GewoonMaarten/soil-sensor/README.md

# soil-sensor 🌱
Schematic and PCB for a capacitive soil moisture sensor.

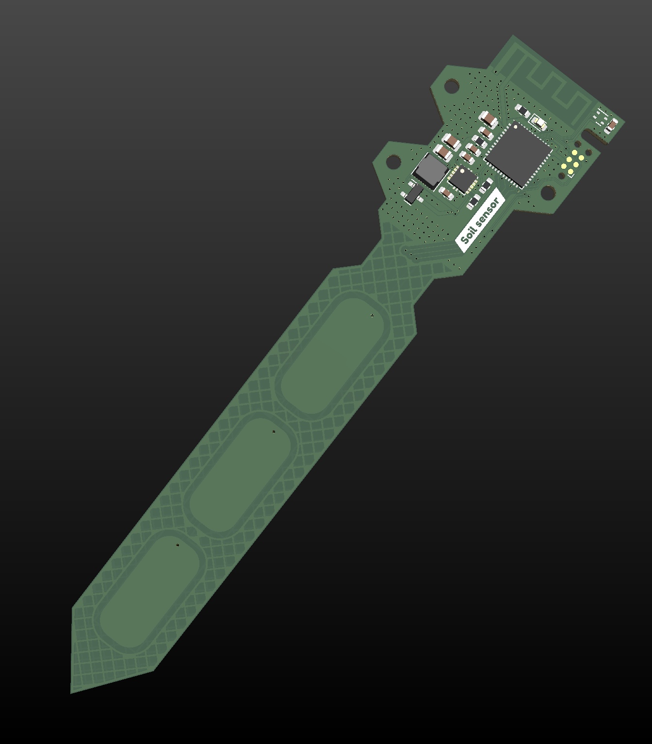
[picture p1: docs/soil_sensor_2.png]
latest release


**See [latest release](../../releases/latest) for schematic and gerbers.**
