GewoonMaarten/soil-sensor/devices/soil-sensor/hardware/v2/README.md

# Out-of-phase soil sensor

Based on the [Capacitive-Based Liquid Level Sensing Sensor Reference Design](https://www.ti.com/tool/TIDA-00317).

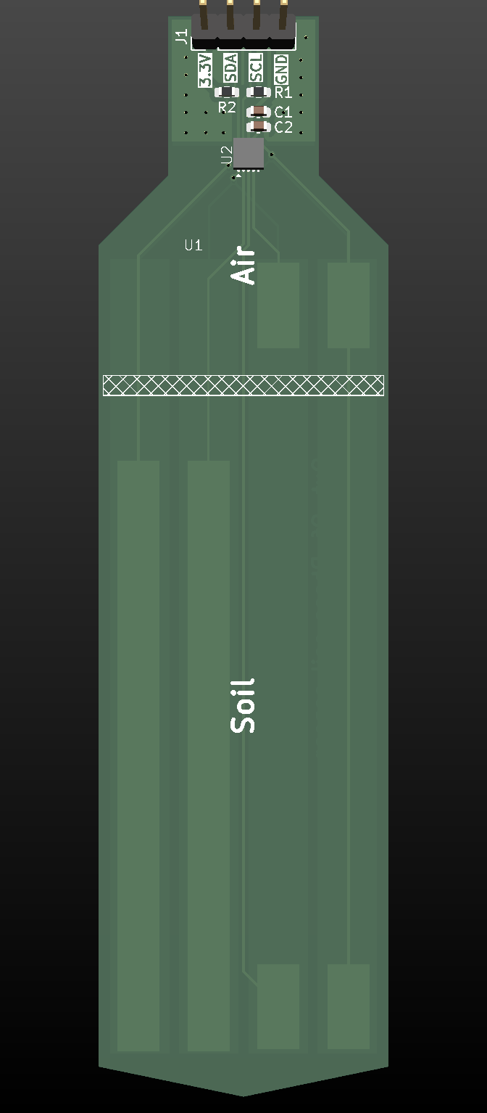
[picture p2: devices/soil-sensor/hardware/v2/soil_probe_oop.png]
