GewoonMaarten/soil-sensor/hardware-libs/3d-models/molex_532610471.step

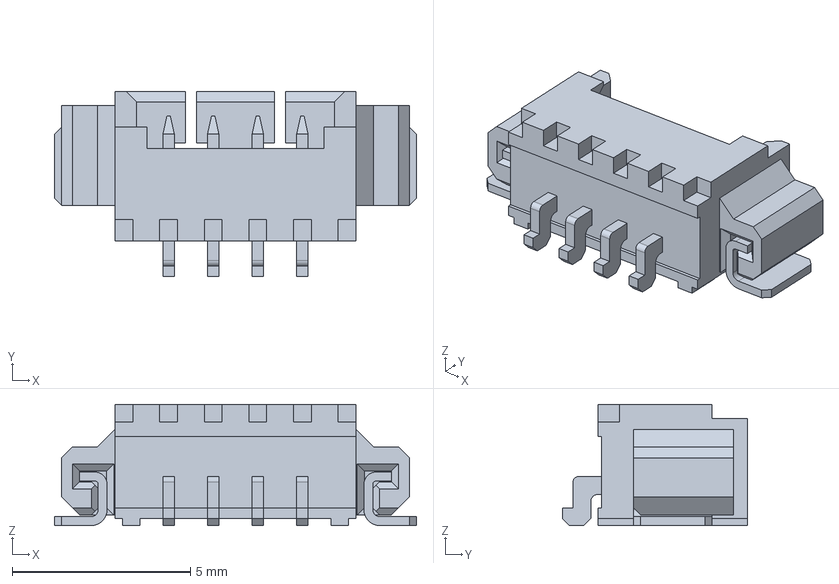
[picture p3: CAD file, 2022-04-29]
hardware-libs/3d-models/molex_532610471.step
10.1 x 5.20 x 3.40 mm
