GewoonMaarten/soil-sensor/hardware-libs/3d-models/sensirion_SHT40.step

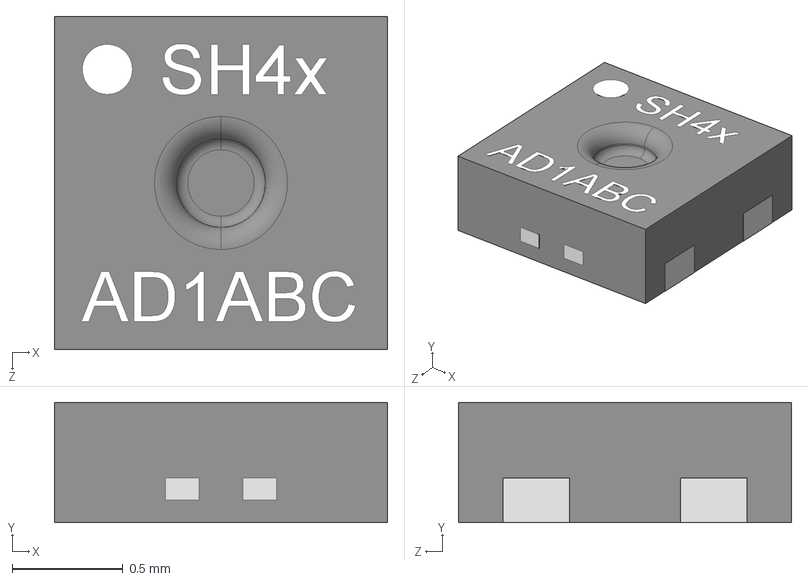
[picture p4: CAD file, 2021-11-27]
hardware-libs/3d-models/sensirion_SHT40.step
1.50 x 0.542 x 1.50 mm
