GewoonMaarten/soil-sensor/(threads)

Thread 1 (2024-04-01):

sharing of your soil-sensor project

aeonSolutions, 2024-04-01:
Hi @GewoonMaarten
awesome PCB work !! keep it up. 👍👍👍👍👍

I'm sharing your soil sensor project in my own PCB repository here:
[https://github.com/aeonSolutions/AeonLabs-Indoor-Smart-Plant-Watering](https://github.com/aeonSolutions/AeonLabs-Indoor-Smart-Plant-Watering)

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
