GewoonMaarten/soil-sensor/devices/soil-sensor/hardware/v2/soil_probe_oop.kicad_pcb

## KiCad design devices/soil-sensor/hardware/v2/soil_probe_oop.kicad_pcb (2026-08-16)

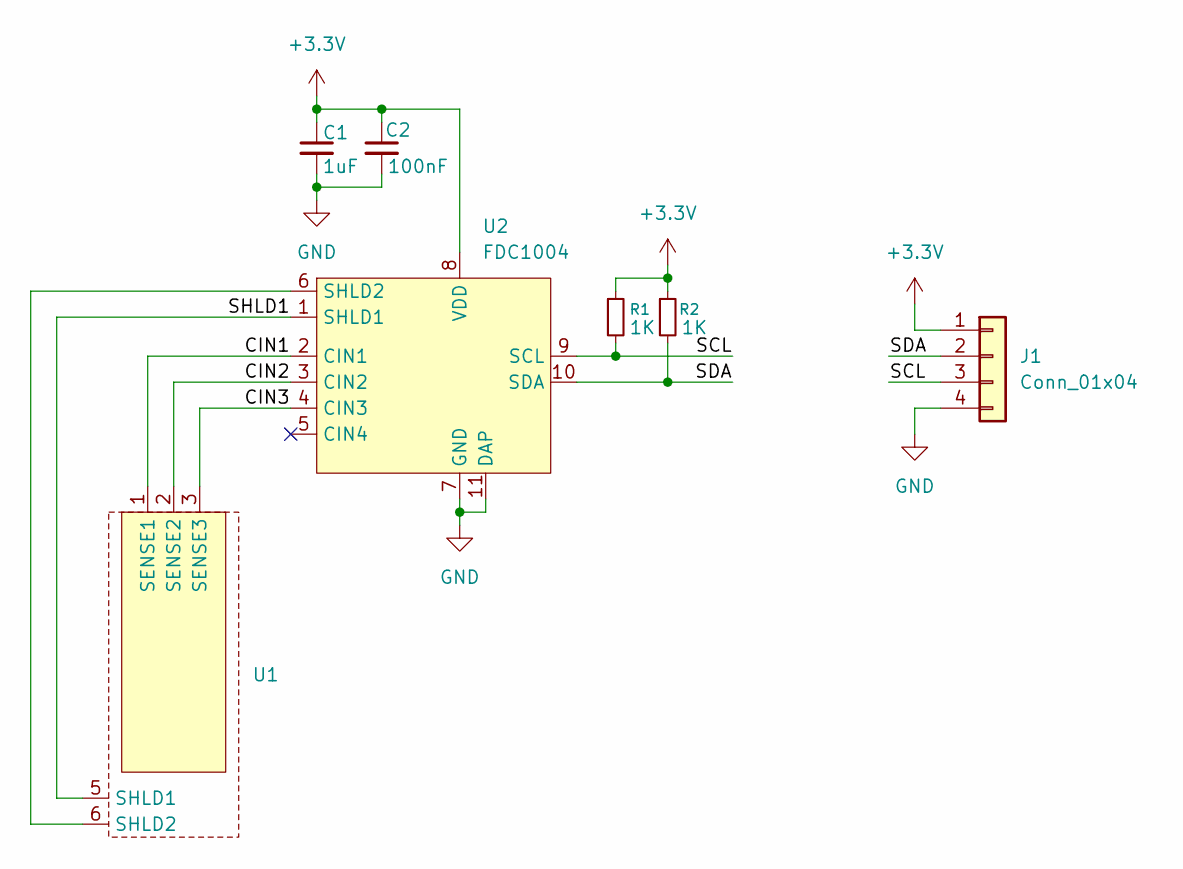
[picture p6: schematic soil_probe_oop.kicad_sch]

Parts:
C1: 1uF; C_0603_1608Metric
C2: 100nF; C_0603_1608Metric
J1: Conn_01x04; PinHeader_1x04_P2.54mm_Vertical
R1, R2: 1K; R_0603_1608Metric
U1: SoilPad_OOP
U2: FDC1004; FDC1004DS

Connections:
+3.3V: C1.1, C2.1, J1.1, R1.1, R2.1, U2.8 (VDD)
/CIN1: U1.1 (SENSE1), U2.2 (CIN1)
/CIN2: U1.2 (SENSE2), U2.3 (CIN2)
/CIN3: U1.3 (SENSE3), U2.4 (CIN3)
/SCL: J1.3, R1.2, U2.9 (SCL)
/SDA: J1.2, R2.2, U2.10 (SDA)
/SHLD1: U1.5 (SHLD1), U2.1 (SHLD1)
GND: C1.2, C2.2, J1.4, U2.7 (GND), U2.11 (DAP)
unnamed: U1.6 (SHLD2), U2.6 (SHLD2)

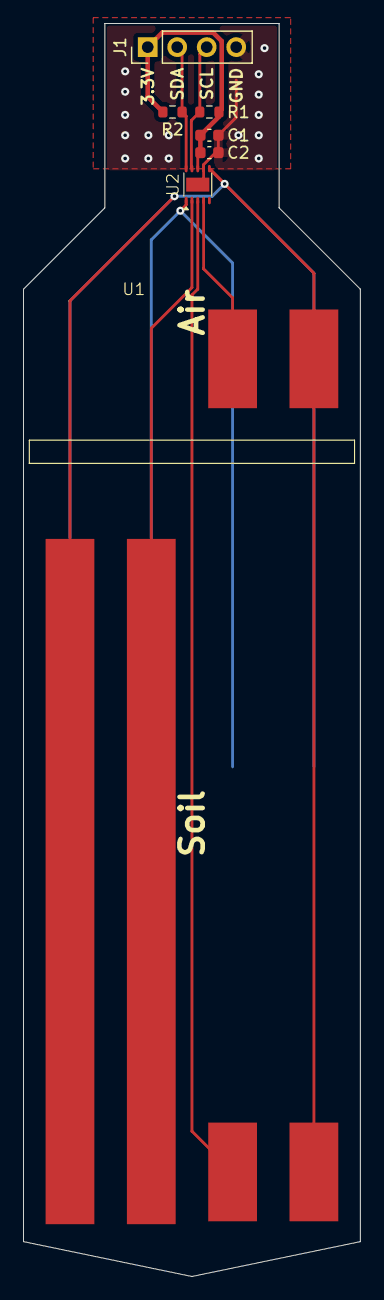
[picture p7: board soil_probe_oop.kicad_pcb from above]

Board: 2 copper layers, 29.0 x 107.9 mm, 7 parts (0 on the bottom side), 9 nets.
