GewoonMaarten/soil-sensor/devices/soil-sensor/hardware/v1/soil_probe.kicad_pcb

## KiCad design devices/soil-sensor/hardware/v1/soil_probe.kicad_pcb (2026-08-16, an earlier design)

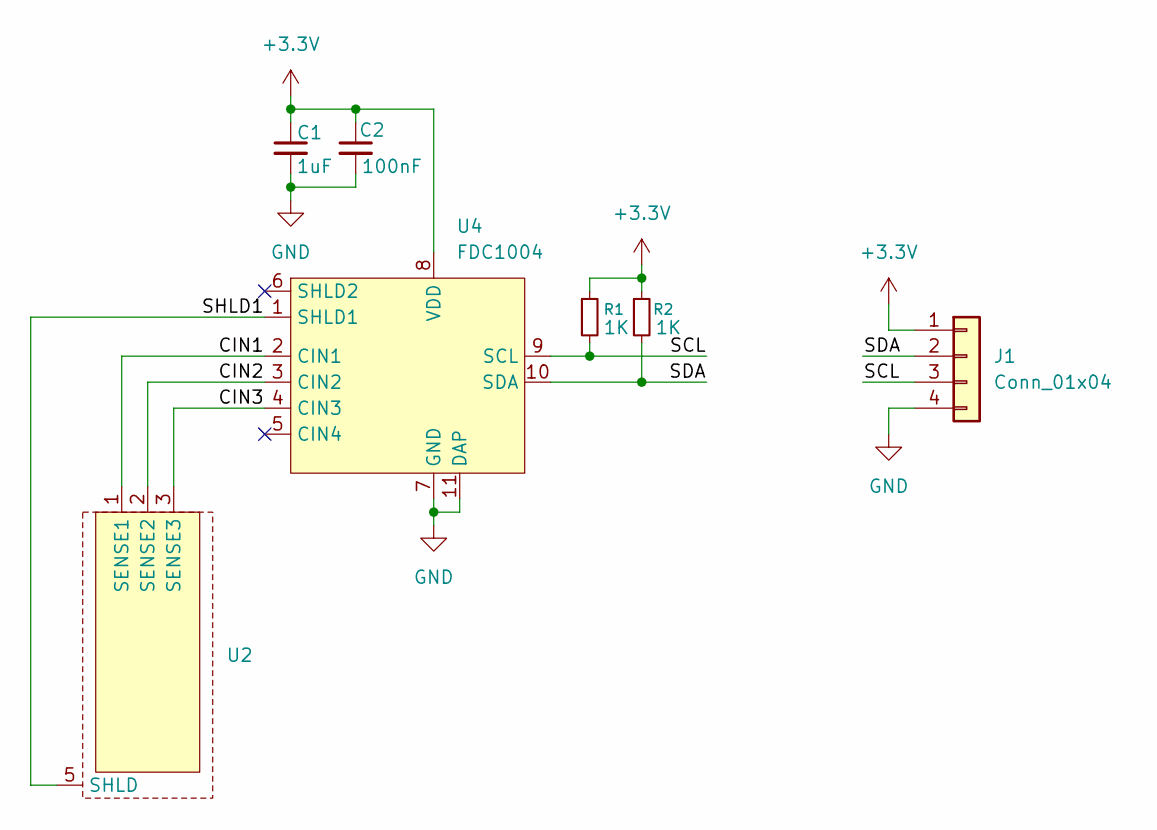
[picture p8: schematic soil_probe.kicad_sch]

Parts:
C1: 1uF; C_0603_1608Metric
C2: 100nF; C_0603_1608Metric
J1: Conn_01x04; PinHeader_1x04_P2.54mm_Vertical
R1, R2: 1K; R_0603_1608Metric
U2: SoilPad_03_SHLD
U4: FDC1004; FDC1004DS

Connections:
+3.3V: C1.1, C2.1, J1.1, R1.1, R2.1, U4.8 (VDD)
/CIN1: U2.1 (SENSE1), U4.2 (CIN1)
/CIN2: U2.2 (SENSE2), U4.3 (CIN2)
/CIN3: U2.3 (SENSE3), U4.4 (CIN3)
/SCL: J1.3, R1.2, U4.9 (SCL)
/SDA: J1.2, R2.2, U4.10 (SDA)
/SHLD1: U2.5 (SHLD), U4.1 (SHLD1)
GND: C1.2, C2.2, J1.4, U4.7 (GND), U4.11 (DAP)

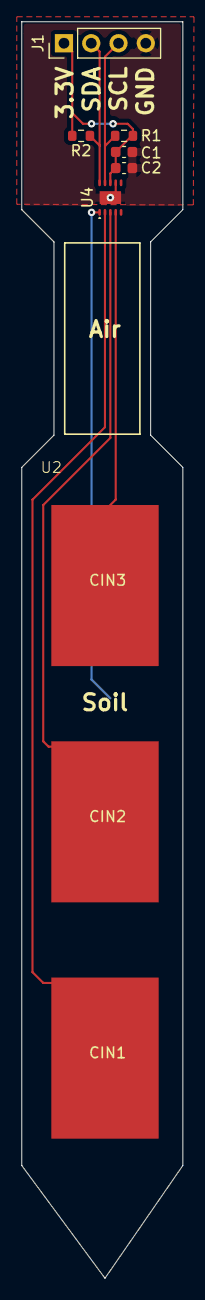
[picture p9: board soil_probe.kicad_pcb from above]

Board: 2 copper layers, 15.0 x 117.0 mm, 7 parts (0 on the bottom side), 8 nets.
