GewoonMaarten/soil-sensor/pcb/boards/soil_sensor_v2/soil_sensor_2.kicad_pcb

## KiCad design pcb/boards/soil_sensor_v2/soil_sensor_2.kicad_pcb (2026-08-16)

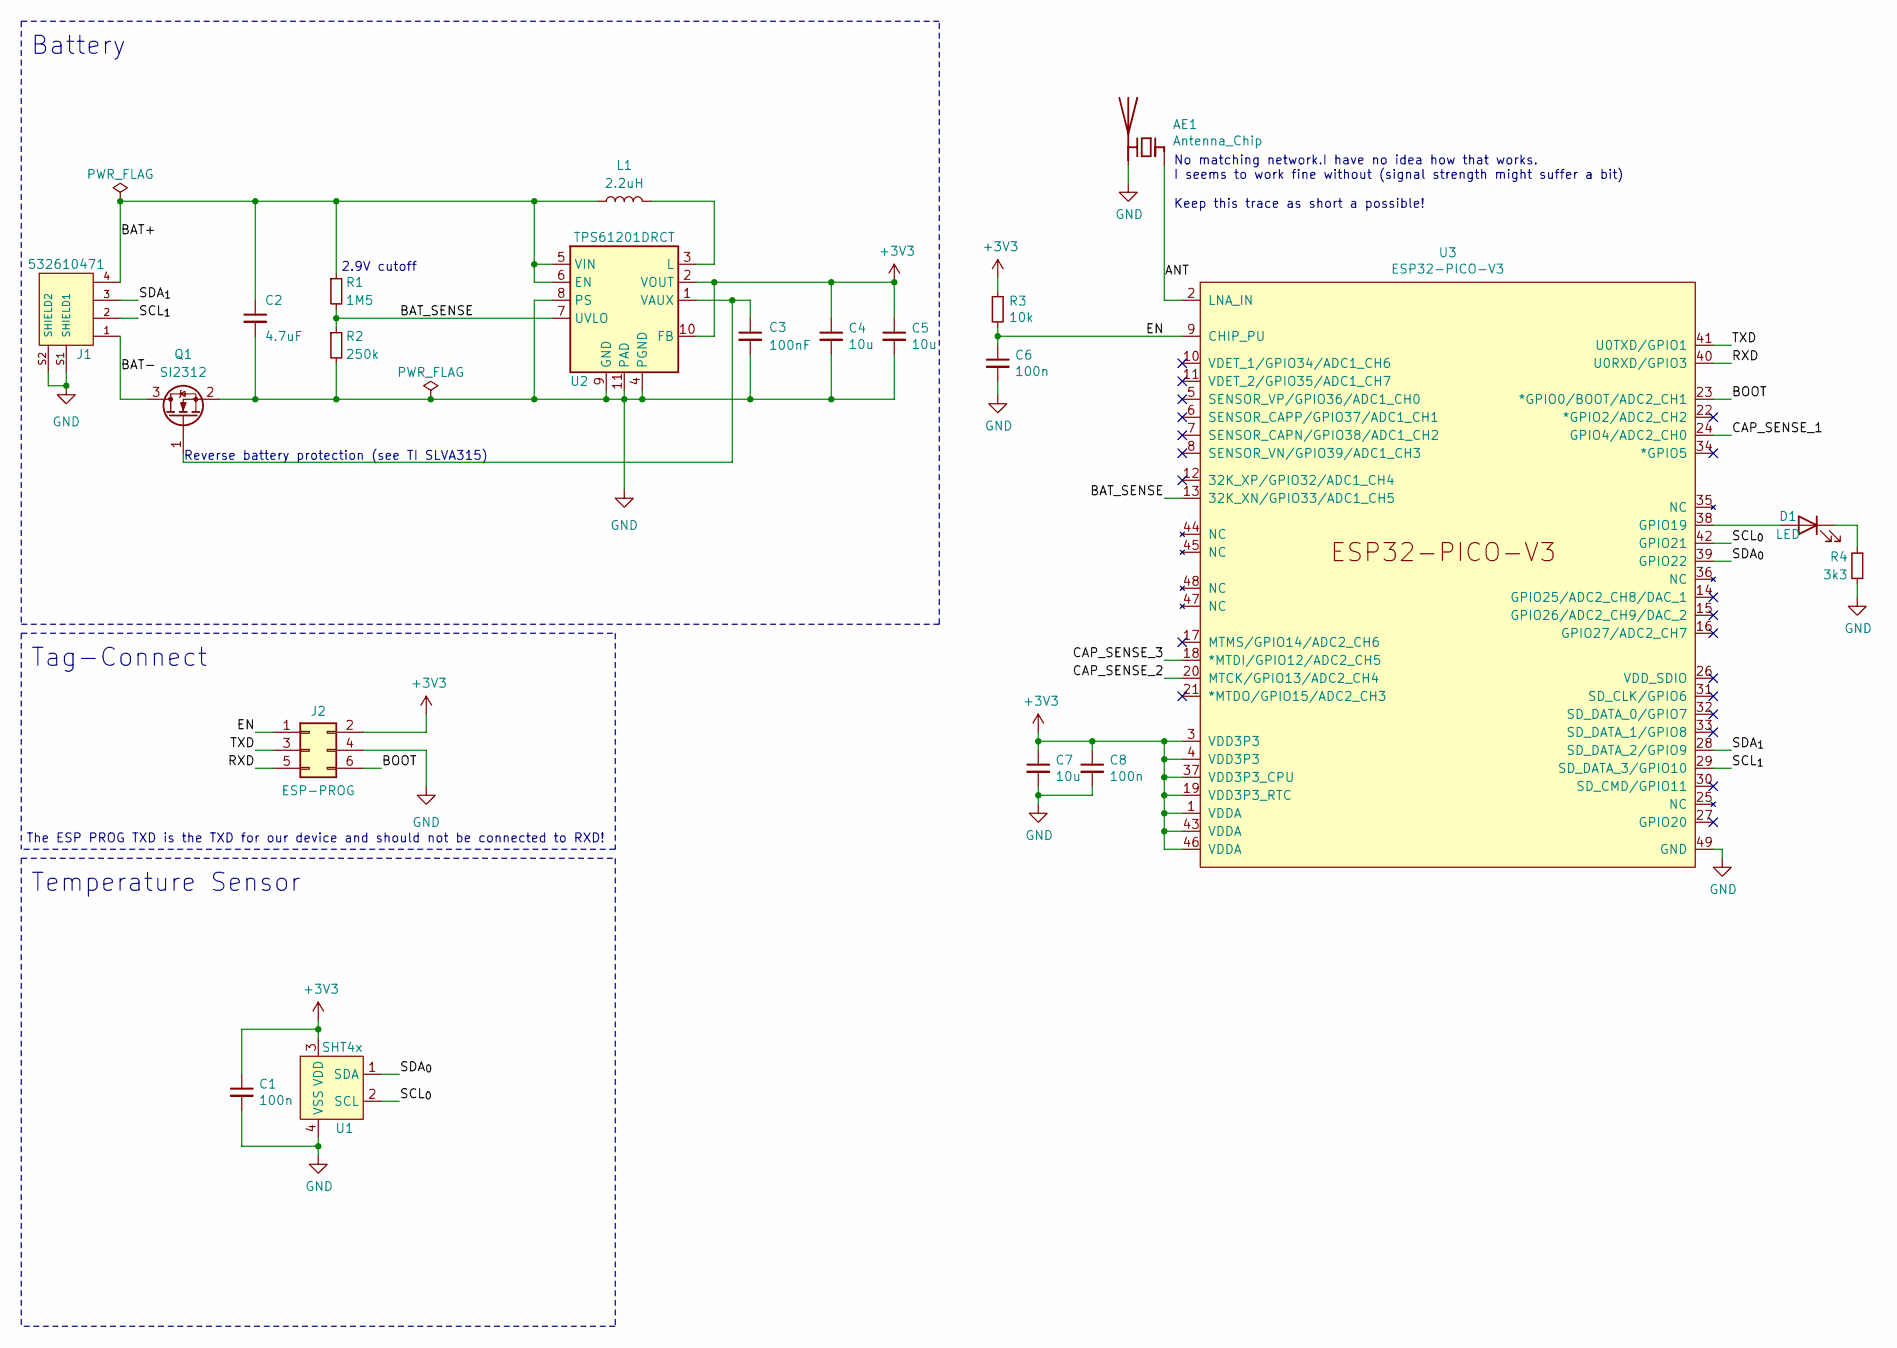
[picture p10: schematic soil_sensor_2.kicad_sch, ESP32 Soil Sensor]

Parts:
AE1: Antenna_Chip; Texas_SWRA117D_2.4GHz_Right
C1, C6, C8: 100n; C_0603_1608Metric
C2: 4.7uF; C_0603_1608Metric
C3: 100nF; C_0603_1608Metric
C4, C5, C7: 10u; C_0805_2012Metric
D1: LED; LED_0603_1608Metric
J1: 532610471; MOLEX_532610471; PARTREV J
J2: ESP-PROG; Tag-Connect_TC2030-IDC-NL_2x03_P1.27mm_Vertical
L1: 2.2uH; L_Taiyo-Yuden_NR-40xx; Digikey NRS4018T2R2MDGJ
Q1: SI2312; SOT-23; Digikey SI2312BDS-T1-E3CT-ND
R1: 1M5; R_0603_1608Metric; Digikey 541-2.87MHCT-ND
R2: 250k; R_0603_1608Metric
R3: 10k; R_0603_1608Metric
R4: 3k3; R_0603_1608Metric
U1: SHT4x; XDCR_SHT40-AD1B-R2
U2: TPS61201DRCT; Texas_S-PVSON-N10_ThermalVias; Digikey 296-21684-1-ND
U3: ESP32-PICO-V3; QFN-48-1EP_7x7mm_P0.5mm_EP5.15x5.15mm; Digikey 1965-ESP32-PICO-V3CT-ND

Connections:
+3V3: C1.1, C4.1, C5.1, C7.1, C8.1, J2.2, R3.1, U1.3 (VDD), U2.2 (VOUT), U2.10 (FB), U3.1 (VDDA), U3.3 (VDD3P3), U3.4 (VDD3P3), U3.19 (VDD3P3_RTC), U3.37 (VDD3P3_CPU), U3.43 (VDDA), U3.46 (VDDA)
/ANT: AE1.1 (FEED), U3.2 (LNA_IN)
/BAT+: C2.1, J1.4, L1.1, R1.1, U2.5 (VIN), U2.6 (EN)
/BAT-: J1.1, Q1.3 (D)
/BAT_SENSE: R1.2, R2.1, U2.7 (UVLO), U3.13 (32K_XN/GPIO33/ADC1_CH5)
/BOOT: J2.6, U3.23 (*GPIO0/BOOT/ADC2_CH1)
/CAP_SENSE_1: U3.24 (GPIO4/ADC2_CH0)
/CAP_SENSE_2: U3.20 (MTCK/GPIO13/ADC2_CH4)
/CAP_SENSE_3: U3.18 (*MTDI/GPIO12/ADC2_CH5)
/EN: C6.1, J2.1, R3.2, U3.9 (CHIP_PU)
/RXD: J2.5, U3.40 (U0RXD/GPIO3)
/SCL_{0}: U1.2 (SCL), U3.42 (GPIO21)
/SCL_{1}: J1.2, U3.29 (SD_DATA_3/GPIO10)
/SDA_{0}: U1.1 (SDA), U3.39 (GPIO22)
/SDA_{1}: J1.3, U3.28 (SD_DATA_2/GPIO9)
/TXD: J2.3, U3.41 (U0TXD/GPIO1)
GND: AE1.2 (PCB_Trace), C1.2, C2.2, C3.2, C4.2, C5.2, C6.2, C7.2, C8.2, J1.S1 (SHIELD1), J1.S2 (SHIELD2), J2.4, Q1.2 (S), R2.2, R4.2, U1.4 (VSS), U2.4 (PGND), U2.8 (PS), U2.9 (GND), U2.11 (PAD), U3.49 (GND)
unnamed: C3.1, Q1.1 (G), U2.1 (VAUX)
unnamed: D1.1 (K), R4.1
unnamed: D1.2 (A), U3.38 (GPIO19)
unnamed: L1.2, U2.3 (L)

Notes on the sheet:
Temperature Sensor
The ESP PROG TXD is the TXD for our device and should not be connected to RXD!
Tag-Connect
Battery
Reverse battery protection (see TI SLVA315)
2.9V cutoff
No matching network.I have no idea how that works. I seems to work fine without (signal strength might suffer a bit) Keep this trace as short a possible!

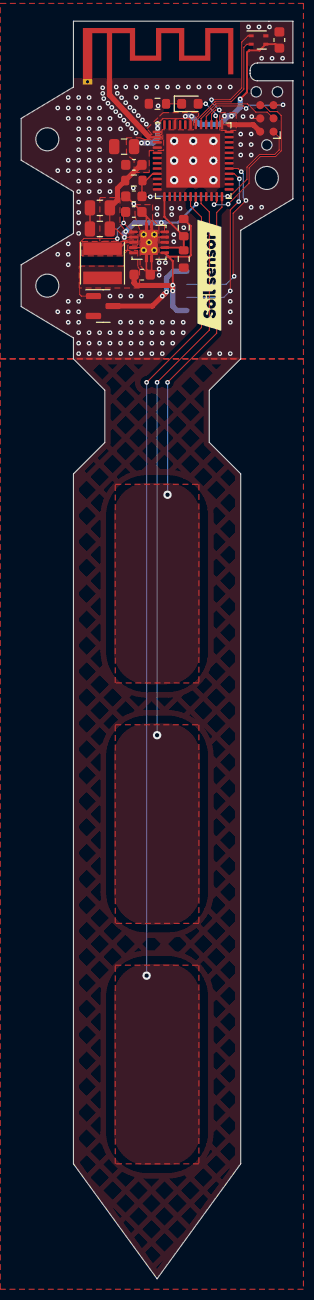
[picture p11: board soil_sensor_2.kicad_pcb from above]

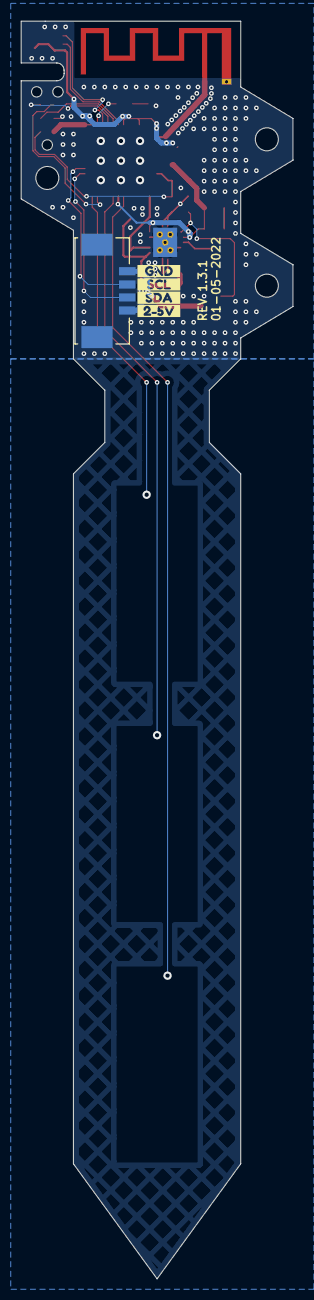
[picture p12: board soil_sensor_2.kicad_pcb from below]

Board: 2 copper layers, 26.0 x 120.3 mm, 26 parts (5 on the bottom side), 18 nets.

Other parts of the board:
kibuzzard-61BE000A: G***; kibuzzard-61BE000A
kibuzzard-61BE001F: G***; kibuzzard-61BE001F
kibuzzard-61BE0016: G***; kibuzzard-61BE0016
kibuzzard-61BE0025: G***; kibuzzard-61BE0025
kibuzzard-61BE0345: G***; kibuzzard-61BE0345
