GewoonMaarten/soil-sensor/(commit log)

2021-11-27 update BMS
    now using the TPS61201DRCT
    [soil_sensor_2.kicad_pcb, soil_sensor_2.kicad_sch]
2021-11-27 added some comments
    [soil_sensor_2.kicad_sch]
2021-11-27 update kicad version
    [soil_sensor_2.kicad_pcb]
2021-11-27 update board version label
    [soil_sensor_2.kicad_pcb]
2022-04-29 move battery off pcb
    [soil_sensor_2.kicad_pcb, soil_sensor_2.kicad_sch]
2022-04-29 chore: move pcb files in new directory
    [soil_sensor_2.kicad_pcb, soil_sensor_2.kicad_sch]
2022-04-30 chore: run docker container privileged
    Easier to use when working with serial devices
2022-04-30 chore: add soil sensor source code
2022-05-01 chore: add cutout to improve temperature isolation
    [soil_sensor_2.kicad_pcb]
2026-08-16 chore: consolidate different projects (#2)
    * chore: update to kicad 10.0
    * chore: move soil_sensor_v2
    * Initial commit for soil-sensor
    * feat: add nrf connect sdk sensor module
    [soil_probe-B_Cu.gbr, soil_probe-B_Mask.gbr, soil_probe-B_Paste.gbr, soil_probe-B_Silkscreen.gbr, soil_probe-Edge_Cuts.gbr, soil_probe-F_Cu.gbr, soil_probe-F_Mask.gbr, soil_probe-F_Paste.gbr]
2026-08-16 feat: add out-of-phase soil probe (#3)
    * feat: add out-of-phase soil probe
    * chore: add readme
    [soil_probe_oop-B_Cu.gbr, soil_probe_oop-B_Mask.gbr, soil_probe_oop-B_Paste.gbr, soil_probe_oop-B_Silkscreen.gbr, soil_probe_oop-Edge_Cuts.gbr, soil_probe_oop-F_Cu.gbr, soil_probe_oop-F_Mask.gbr, soil_probe_oop-F_Paste.gbr]
2026-08-18 chore: reorganize directory structure (#5)
    * refactor: move files
    * refactor: new folder structure (again)
    * fix: update CMakeLists files to support new directory structure
    [TI_HDC1080.step, molex_532610471.step, sensirion_SHT40.step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]
